Soopahfly/3DPrint-HeberMMS2-MCBlueBridge/Print_files/01_Low_profile_LED_and_cable_guides/MMS2_left_flap_low_profile_full.stl

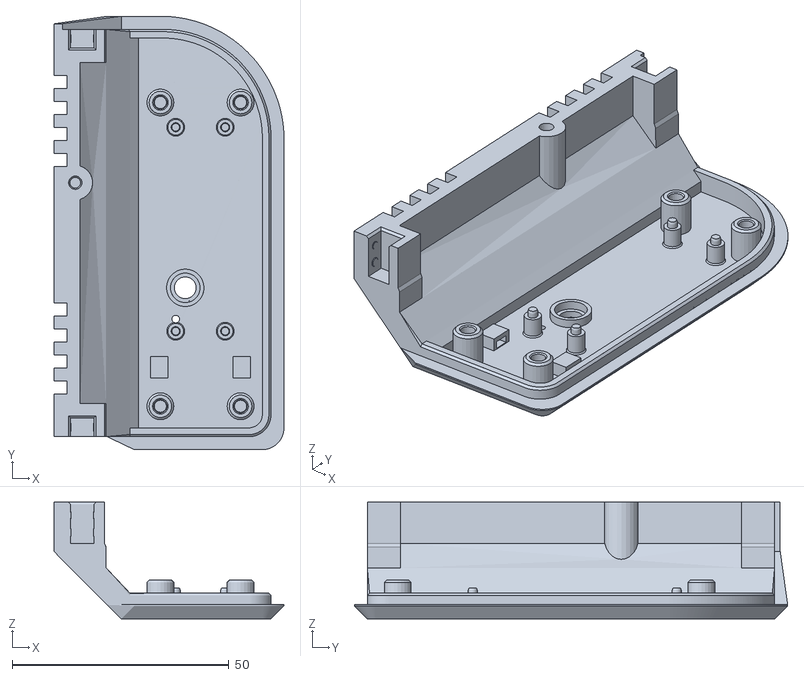
[picture p2: CAD file, 2026-11-11]
Print_files/01_Low_profile_LED_and_cable_guides/MMS2_left_flap_low_profile_full.stl
53.0 x 99.9 x 26.9
