Soopahfly/3DPrint-HeberMMS2-MCBlueBridge/Fit_checks/mount_and_button_fit_test_low_profile.stl

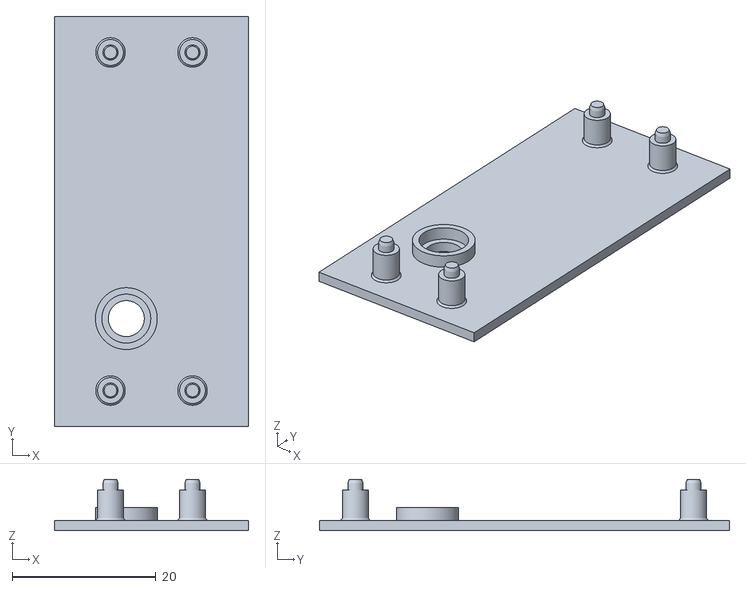
[picture p3: CAD file, 2026-11-11]
Fit_checks/mount_and_button_fit_test_low_profile.stl
27.0 x 57.0 x 7.14
