Soopahfly/3DPrint-HeberMMS2-MCBlueBridge/Print_files/01_Low_profile_LED_and_cable_guides/button_short.stl

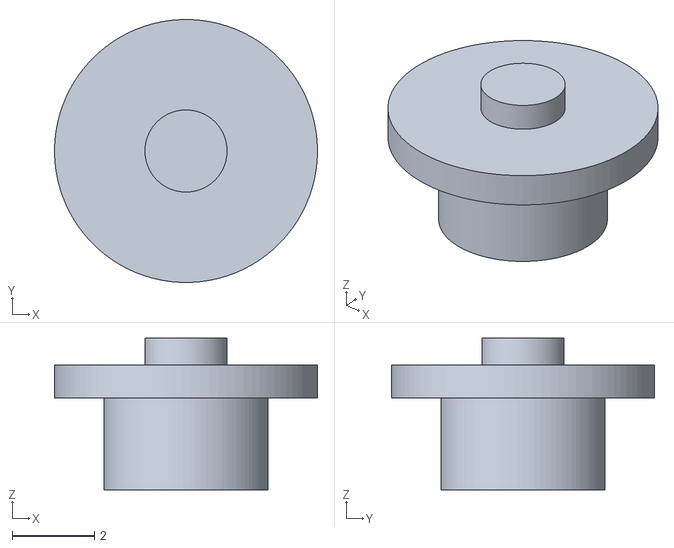
[picture p4: CAD file, 2026-11-11]
Print_files/01_Low_profile_LED_and_cable_guides/button_short.stl
6.40 x 6.40 x 3.69
