Soopahfly/3DPrint-HeberMMS2-MCBlueBridge/Print_files/02_Raised_LED_and_cable_guides/button_long.stl

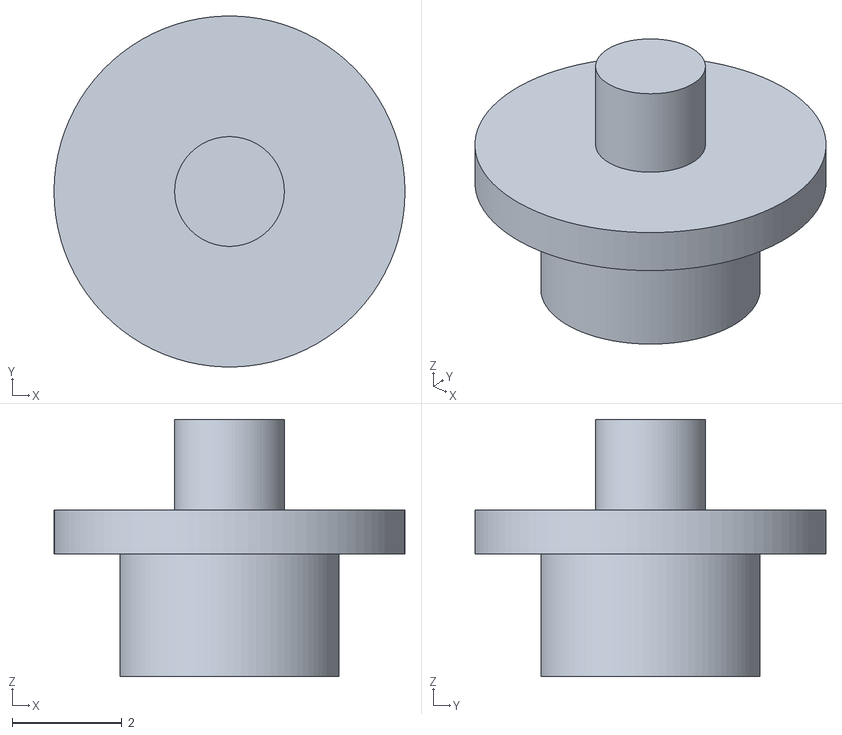
[picture p5: CAD file, 2026-11-11]
Print_files/02_Raised_LED_and_cable_guides/button_long.stl
6.40 x 6.40 x 4.69
