Soopahfly/3DPrint-HeberMMS2-MCBlueBridge/Fit_checks/USB_cable_tie_fit_test.stl

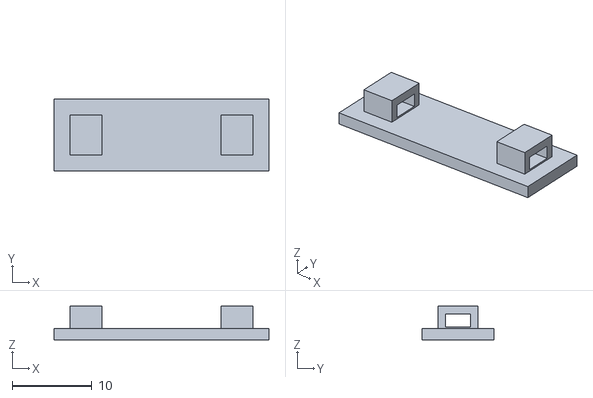
[picture p6: CAD file, 2026-11-11]
Fit_checks/USB_cable_tie_fit_test.stl
27.0 x 9.00 x 4.24
