Soopahfly/3DPrint-HeberMMS2-MCBlueBridge/Fit_checks/peg_fit_2p10mm.stl

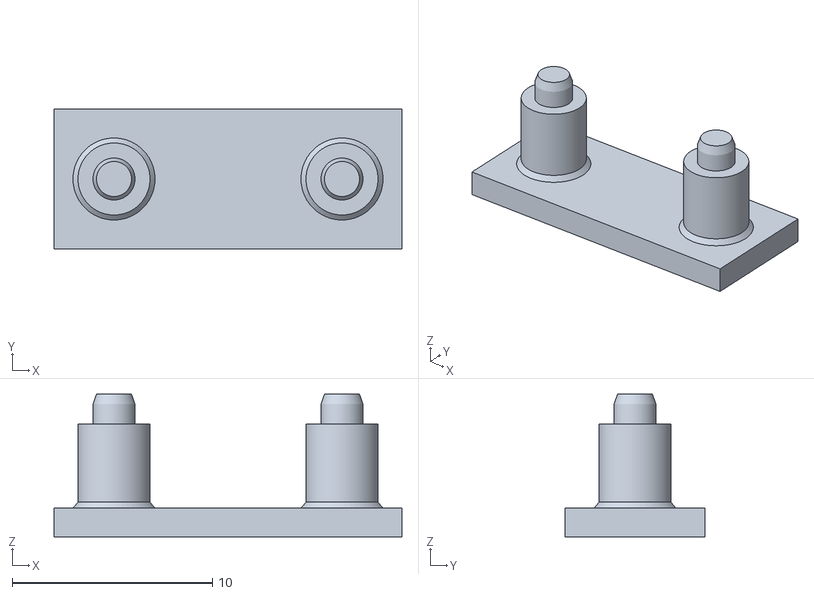
[picture p7: CAD file, 2026-11-11]
Fit_checks/peg_fit_2p10mm.stl
17.4 x 7.00 x 7.14
