Soopahfly/3DPrint-HeberMMS2-MCBlueBridge/Fit_checks/button_aperture_fit_test_5p00mm.stl

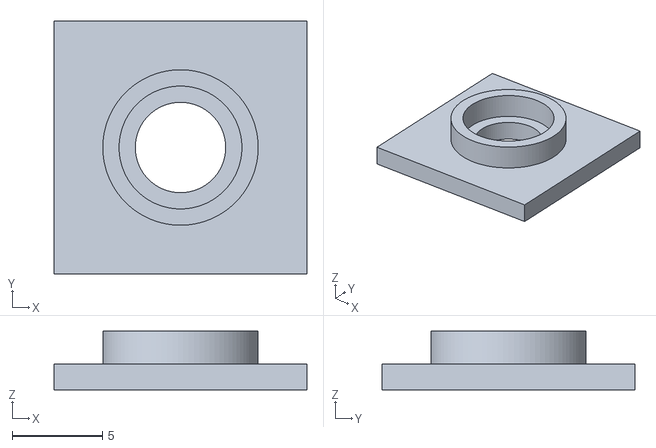
[picture p9: CAD file, 2026-11-11]
Fit_checks/button_aperture_fit_test_5p00mm.stl
14.0 x 14.0 x 3.24
