Soopahfly/3DPrint-HeberMMS2-MCBlueBridge/Fit_checks/light_pipe_fit_test_1p75mm.stl

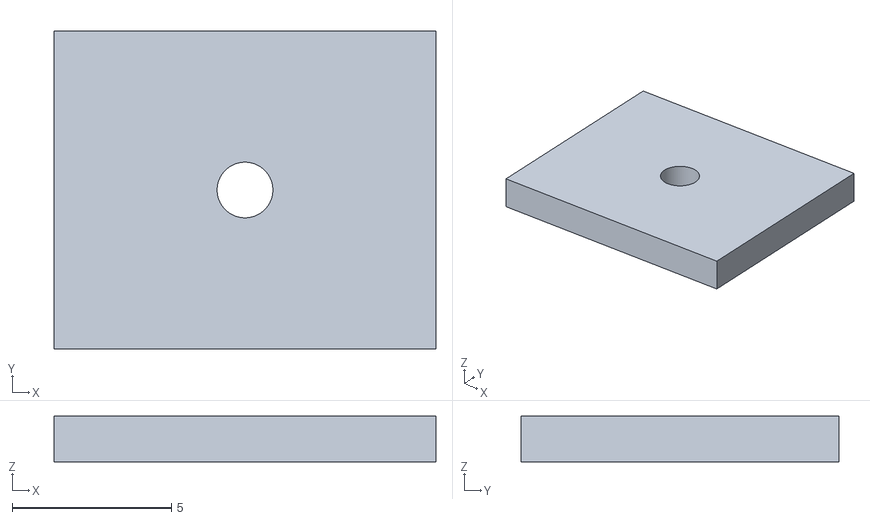
[picture p10: CAD file, 2026-11-11]
Fit_checks/light_pipe_fit_test_1p75mm.stl
12.0 x 10.0 x 1.44
