Soopahfly/3DPrint-HeberMMS2-MCBlueBridge/(list of files, cad)

Other CAD files:
Print_files/02_Raised_LED_and_cable_guides/MMS2_left_flap_raised_full.stl
Print_files/01_Low_profile_LED_and_cable_guides/MMS2_right_flap_low_profile_full.stl
Print_files/02_Raised_LED_and_cable_guides/MMS2_right_flap_raised_full.stl
Print_files/03_Raised_basic_optional/MMS2_left_flap_raised_basic.stl
Print_files/03_Raised_basic_optional/MMS2_right_flap_raised_basic.stl
